inspireFly-VT/Pocketqube-parent-antennaBoard/doc/chapters/Acknowledgments.tex

%
% Acknowledgments.tex
%
% Copyright (C) 2025 by Inspirefly.
%
% 2.305 GHz Patch Antenna Documentation
%

\chapter*{Acknowledgments}
\addcontentsline{toc}{chapter}{Acknowledgments}

Thanks to \textbf{Alek Salvetti} for the MATLAB used throughout this work, including the template antenna \path{matlab/Antenna_minimalistic.mat}, the particle-swarm optimizer \path{matlab/MPA_opt_swrm.m}, and the \path{matlab/best.txt} baseline, as well as guidance on circular-polarization and feed strategies. Also thanks to \textbf{Shane Wyman} for being the Avionics team lead and for his design feedback as a whole.

\vspace{1em}

\bibliography{references/antenna,references/site,references/msp430f6659,references/rf4463f30,references/si4463,references/github}

\addcontentsline{toc}{chapter}{References}
