inspireFly-VT/Pocketqube-parent-antennaBoard/doc/header/authorpage.tex

%
% authorpage.tex
%
% Copyright (C) 2025 by Inspirefly.
%
% 2.305 GHz Circular Patch Antenna Documentation
%
% This work is licensed under the Creative Commons Attribution-ShareAlike 4.0
% International License. To view a copy of this license,
% visit http://creativecommons.org/licenses/by-sa/4.0/.
%

%
% \brief Author page.
%
% \author Inspirefly Antenna Team
%
% \institution Inspirefly / SpaceLab heritage
%
% \version 1.0
%

\thispagestyle{empty}

\begin{center}

\textbf{\thetitle}

\textit{\today}

\vspace{1cm}

\textbf{Project:}

PocketQube Parent Antenna Board -- Inspirefly

\vspace{1cm}

\textbf{Authors:}

Christian G. \\
Inspirefly Antenna Team \\

\vspace{1cm}

\textbf{Contributing History:}

SpaceLab TTC documentation template by Gabriel Mariano Marcelino \\

\vspace{1cm}

\textbf{Revision Control:}

\end{center}

\begin{table}[!ht]
    \begin{center}
        \begin{tabular}{c l p{5cm} c}
            \toprule[1.5pt]
            \textbf{Version} & \textbf{Author}  & \textbf{Changes}    & \textbf{Date} \\
            \midrule
            1.0     & C. G.                     & Circular patch V3, dual coax, FR-408HR stack & 2026/04/28 \\
            0.9     & C. G.                     & Import patch to KiCAD, DXF flow & 2026/03/01 \\
            0.5     & C. G.                     & CircularPatch / HexagonalPatch HFSS & 2025/12/04 \\
            0.2     & C. G.                     & Square aperture calculations & 2025/11/20 \\
            \bottomrule[1.5pt]
        \end{tabular}
    \end{center}
\end{table}

\vfill

\begin{figure}[!h]
	\begin{center}
		
	\end{center}
\end{figure}

\textcopyright\  2025--2026 by Inspirefly. \thetitle. This work is licensed under the Creative Commons Attribution-ShareAlike 4.0 International License. To view a copy of this license, visit \href{http://creativecommons.org/licenses/by-sa/4.0/}{http://creativecommons.org/licenses/by-sa/4.0/}. Template adapted from SpaceLab (UFSC).
