inspireFly-VT/Pocketqube-parent-antennaBoard/doc/patch-doc-v1.0.pdf

### INSPIREFLY-PQ-PATCH-DOC-v1.0

2.305 GHz Circular Patch Antenna – Parent Antenna Board

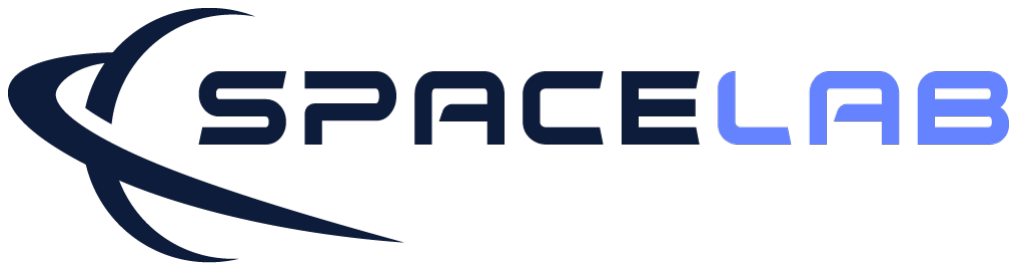
[picture p1: figure]

# 2.305 GHz Circular Patch Antenna

2.305 GHz Circular Patch Antenna
Inspirefly, PocketQube Parent Antenna Board – 2.305 GHz S-band

### April 2026

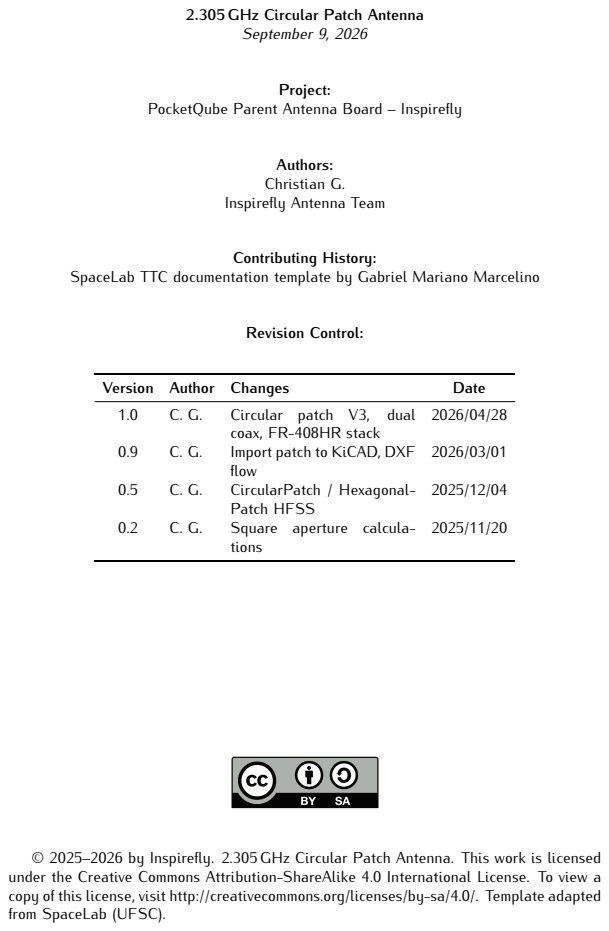
[picture p2: page 3]
September 9, 2026; Project:; Contributing History:; Revision Control:; Version Author Changes; Date; Circular patch V3,; dual; Import patch to KiCAD, DXF; CircularPatch / Hexagonal-; Square aperture calcula-; tions

2.305 GHz Circular Patch Antenna

PocketQube Parent Antenna Board – Inspirefly

Authors:
Christian G.
Inspirefly Antenna Team

SpaceLab TTC documentation template by Gabriel Mariano Marcelino

coax, FR-408HR stack
flow
Patch HFSS

© 2025–2026 by Inspirefly. 2.305 GHz Circular Patch Antenna. This work is licensed
under the Creative Commons Attribution-ShareAlike 4.0 International License. To view a
copy of this license, visit http://creativecommons.org/licenses/by-sa/4.0/. Template adapted
from SpaceLab (UFSC).

### List of Figures

2.1 Earliest HFSS model | | 6
2.2 HFSS model, final circular patch | | 7
2.3 Circular patch design parameters | | 8
3.1 S11, final circular patch | | 16
3.2 3D gain, final circular patch | | 17
3.3 Axial ratio vs theta | | 18
3.4 KiCAD F.Cu views | | 20
3.5 KiCAD B.Cu views | | 20

v

### List of Tables

2.1 Final PCB stackup from antennaBoard.kicad_pcb | | 7
2.2 Key history for the 2.305 GHz patch | | 12
3.1 Analytical radius versus substrate (with Eq. 2.2 correction) | | 13

### vii

### Nomenclature

AEDT | Ansys Electronics Desktop
AR | Axial Ratio
BW | Bandwidth
DXF | Drawing Exchange Format
GND | Ground
HASL | Hot Air Solder Leveling
HFSS | High Frequency Structure Simulator
PCB | Printed Circuit Board
RF | Radio Frequency
RHCP | Right-Hand Circular Polarization
RL | Return Loss
S-band | 2–4 GHz band
S11 | Reflection coefficient
S21 | Transmission coefficient
SDR | Software-Defined Radio
SMA | SubMiniature version A
SMD | Surface-Mount Device
STEP | Standard for the Exchange of Product Data
TM | Transverse Magnetic
U.FL | Ultra Flat Light coaxial connector standard
UHF | Ultra High Frequency
VNA | Vector Network Analyzer

ix

### Contents

List of Figures | v
List of Tables | vii
Nomenclature | ix
1 Introduction | 1
2 Methodology | 5
3 Results | 13
4 Discussion | 21
5 Conclusion | 23
Acknowledgments | 25
References | 27

xi

### CHAPTER 1

### Introduction

The 1P PocketQube is a 50 × 50 × 50 mm cube, with mass below 250 g. This document records the design of a 2.305 GHz centered circular microstrip patch antenna for the PocketQube parent antenna board. The frequency was selected to provide an S-band downlink/uplink channel separate from UHF telemetry, with sufficient bandwidth for higher data rates and with regulatory compatibility in the 2.25–2.35 GHz region. The antenna is realized as a probe-fed circular patch on a multilayer PCB, with two orthogonal feed points intended for circular polarization through an external quadrature power divider.

### 1.1 Why a Circular Patch

Rectangular and circular patches share the same operating principle: a resonant cavity formed by the metal patch, the grounded dielectric substrate, and the fringing fields at the edges. However, the circular geometry was chosen for two reasons.
First, the dominant TM11 mode of a circular patch has a field distribution with azimuthal symmetry, which simplifies generation of circular polarization by feeding at two points separated by 90◦
in space and driven in quadrature. For a rectangular patch, circular polarization requires either a nearly square patch with truncated corners or a dual-feed with unequal slot perturbations; both are more sensitive to etching tolerances at 2.3 GHz than the symmetric circular case.
Second, for a given resonant frequency the circular patch occupies less area than the circumscribed square patch and has no sharp corners where current crowding increases loss. On a 50 mm board, a radius near 19–20 mm (see Chapter 2) leaves a usable groundplane ring for connectors and keep-out, while a λg/2 square patch with the same substrate would require a larger footprint once fringing corrections are included.

Chapter 1. Introduction

### 1.2 Objectives

The design objectives for the parent antenna board are:

1. Resonant frequency f0 = 2.305 GHz, with S11 < −10 dB across at least 20 MHz.
2. Realized gain greater than 5 dBi at boresight (zenith) and axial ratio below 3 dB for the circularly polarized configuration.
3. Input impedance near 50 Ω at each coax feed, compatible with the Molex 732511350 U.FL-compatible connector and the external power divider APS-02-WBM-LP-DF-
CC.
4. Full integration into the KiCAD PCB stack without post-assembly tuning stubs, using the same fabrication stack available for the rest of the spacecraft electronics
(FR-408HR multilayer).
5. Reproducibility: all geometry originates from the ANSYS HFSS parametric model and is exported via DXF to the KiCAD footprint Inspire-
fly:CircularPatchAntenna, with version control in git.

1.3. Document Structure

### 1.3 Document Structure

Chapter 2 develops the underlying theory and describes the three tool chains used: MAT-

### LAB Antenna Toolbox for initial analysis, ANSYS HFSS (via AEDT files in ansys/) for

full-wave finite-element verification, and KiCAD 10.0 for layout (KiCAD/antennaBoard/). Chapter 3 reports the numerical results from each stage, including the limits of the early rectangular-patch estimate and the current best MATLAB optimization log (matlab/best.txt). Chapter 4 interprets those results and records design decisions visible in git history, such as the move from a single MMCX feed to two orthogonal coax feeds and the substrate change from Rogers RO4350B to FR-408HR. Chapter 5 summarizes status and remaining verification steps before fabrication.

### CHAPTER 2

### Methodology

This chapter shows how the antenna was sized — the patch radius math, why FR-408HR was chosen over Rogers, and how the three tools (MATLAB for quick sweeps, HFSS for full-wave checks, KiCAD for layout) fit together. Equations are given in final form.

### 2.1 Circular Patch Theory

### 2.1.1 Cavity Model and Resonant Frequency

A circular microstrip patch of physical radius a on a grounded substrate of thickness h and relative permittivity εr

is modeled as a cylindrical cavity with electric walls at the patch and ground plane and a magnetic wall at the periphery [1, 2]. The resonant frequencies of the TMnm modes are

fnm =

χnm c
2πae

√
εr
, | (2.1)

### where c = 2.99792458 × 10⁸ m s⁻¹

, χnm is the m-th zero of the derivative J

′
n

### (x) of the

Bessel function of the first kind, and ae is the effective radius that accounts for fringing.
For the dominant mode TM11, χ11 = 1.84118. All higher modes (TM21 at χ21 = 3.0542,
TM02 at 3.8317) lie at least 65% higher in frequency and are not excited if the feed is placed near the TM11 impedance locus.
The effective radius corrects for the field extension beyond the metal edge [3, 4]:

ae = a

1 + 2h
πaεr

ln πa
2h

+ 1.7726

1/2
. | (2.2)

Equation 2.2 is accurate for a/h ≫ 1 and εr ≲ 10, both satisfied here (a/h ≈ 140 for h ≈ 0.14 mm). In the design flow the physical radius a is obtained by inverting Eqs. 2.1– 2.2 iteratively: choose a, compute ae, evaluate f11, and adjust a until f11 = 2.305 GHz. The quality factor, bandwidth, and radiation efficiency are set by the cavity loss budget (radiation, conductor, dielectric, surface wave). For a thin substrate (h/λ0 < 0.02) the fractional bandwidth is approximately

### BW ≈ 3.77 εr − 1

ε

2
r

h
λ0

a
λ0
, | (2.3)

which places the expected −10 dB bandwidth at 1–2% for the stack used here. This is acceptable for a single channel but requires careful impedance matching.

Chapter 2. Methodology

### 2.1.2 Feed Polarization

Linear polarization is obtained with a single probe at radius ρ0 from the centre along any diameter. Circular polarization is obtained with two probes at (ρ0, 0) and (0, ρ0) driven with equal amplitude and 90◦ phase difference. The input resistance at a radial offset ρ0 for the TM11 mode varies as

Rin(ρ0) ≈ Redge

J

2
1

(kρ0)
J

2
1

### (kae)

, k =

2πf√
εr
c
, | (2.4)

so the feed is moved inward from the edge until Rin ≈ 50 Ω and the reactance is tuned out. The final board implements two orthogonal coax feeds and relies on an external quadrature

### divider (APS-02-WBM-LP-DF-CC) rather than an on-board branch-line hybrid, to keep

the 50 mm board area available for the patch and to allow testing of linear vs. circular configurations by terminating one port.

### 2.1.3 Early Rectangular Estimate

Initially, a λg/2 square patch with slot perimeter equal to λg was used:

λ0 =

c
f

=

2.99792458 × 10⁸
2.305 × 10⁹
| ≈ 0.13006 m, | (2.5)

λg =

λ0
√
εr
, | | (2.6)
L = λg/2, | slot perimeter = λg. | (2.7)

### With Rogers RO4350B (εr = 3.66, h = 0.168 mm) this gives λg ≈ 35.54 mm and L ≈

17.77 mm. This model is correct for a rectangular half-wave patch but was superseded for the circular geometry, where Eq. 2.1 governs. It remains in the repo for record-keeping.

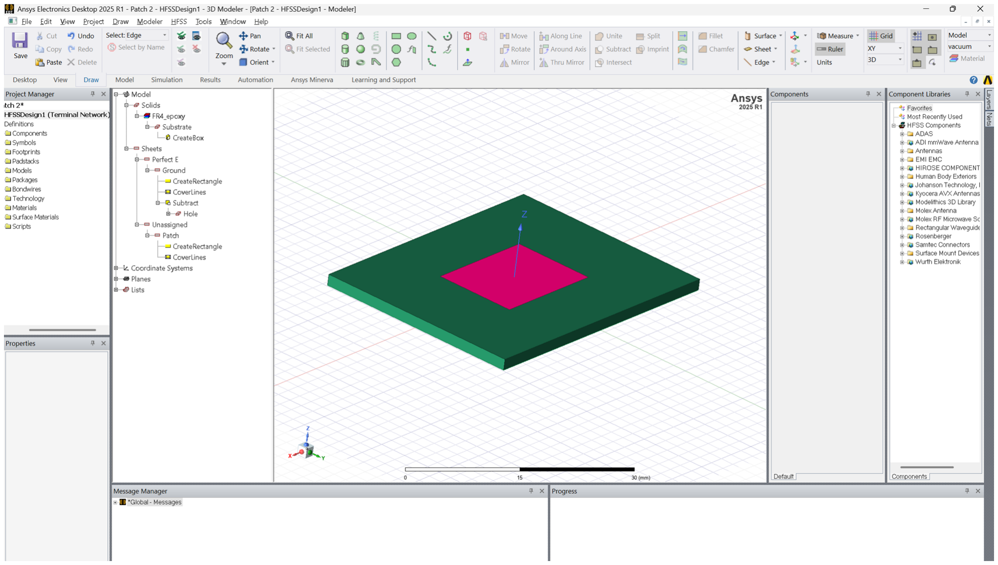
[picture p3: figure]

Figure 2.1: Earliest HFSS model

2.2. Materials and PCB Stackup

### 2.2 Materials and PCB Stackup

The initial analytical estimate assumed Rogers RO4350B (εr = 3.66 ± 0.05, tan δ =
0.0037 at 10 GHz). The fabricated stack was moved to Isola FR-408HR (εr = 3.68,
tan δ = 0.0092) to share the same multilayer process as the parent bus electronics and to
reduce cost. The final stack defined in KiCAD/antennaBoard/antennaBoard.kicad_pcb
is a 4-copper-layer board with total thickness 1.3414 mm:

Table 2.1: Final PCB stackup from antennaBoard.kicad_pcb.

Layer | Type | Thickness (mm) | εr / tan δ
F.Cu | copper | 0.035 | –
Dielectric 1 prepreg FR-408HR | 0.100 | 3.68 / 0.0092
In1.Cu | copper | 0.035 | –
Dielectric 2 core FR-408HR | 0.9814 | 3.68 / 0.0092
In2.Cu | copper | 0.035 | –
Dielectric 3 prepreg FR-408HR | 0.100 | 3.68 / 0.0092
B.Cu | copper | 0.035 | –
Total | | 1.3414

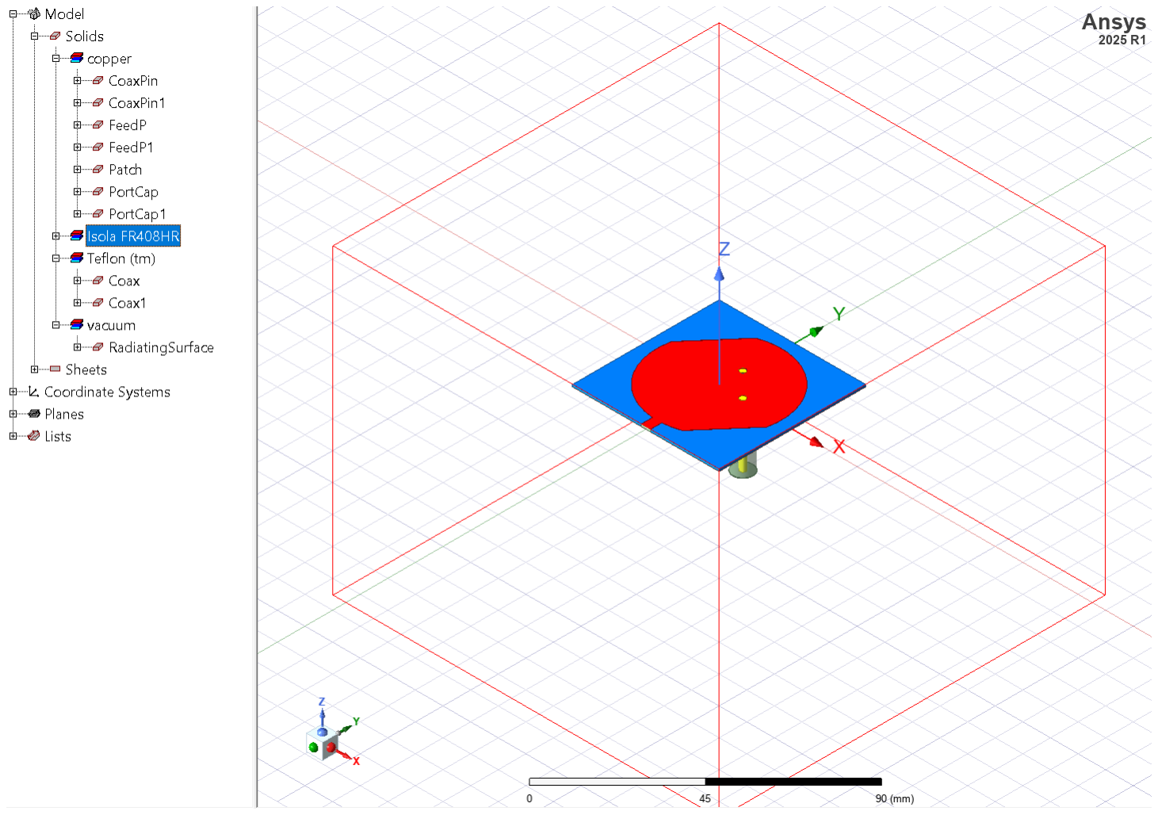
[picture p4: figure]

Figure 2.2: HFSS model, final circular patch

Chapter 2. Methodology

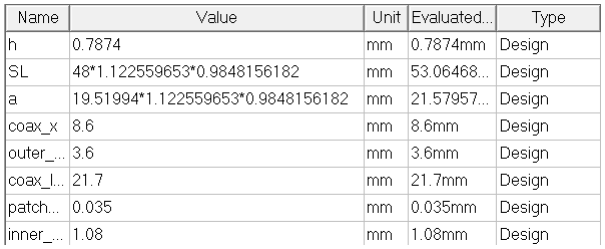
[picture p5: figure]

Figure 2.3: Circular patch design parameters

The RF patch resides on F.Cu; In1.Cu and In2.Cu are used for routing and shielding; B.Cu is the solid ground plane. Two through-vias (pad 0.6 mm, drill 0.3 mm) connect each coax centre conductor from the patch layer to the feed network on B.Cu. The MATLAB exploration model (matlab/MPA_opt_swrm.m) approximates this stack as a single dielectric of h = 0.0994 mm, εr = 4.0, tan δ = 0 with 0.035 mm copper, which is thinner than the fabricated stack and represents a conservative bandwidth estimate.

### 2.3. MATLAB

### 2.3 MATLAB

Rapid design-space exploration was performed in MATLAB R2024b Antenna Toolbox (ma
tlab/MPA_opt_swrm.m). The script builds a pcbStack with a rectangular board of side
1.5 W and a square patch of side W with two opposite corners truncated by 45◦
squares of
side W

√
2 ×PatchFrac. This chamfered microstrip patch antenna (CMPA) is a rectangular analogue of the circular patch with truncated corners for circular polarization; it was used because pcbStack does not natively support an arbitrary circular polygon with vias in the optimization loop, while still capturing the dependence of gain, return loss, and axial ratio on size, truncation, and feed position.
Three variables are optimized by particle swarm (particleswarm, SwarmSize 400, MaxIterations 1000, UseParallel true):
1. W = Board_W ∈ [10, 50] mm,
2. PatchFrac ∈ [0.01, 0.5],
3. FeedFrac ∈ [−0.9, 0.9], defining the feed offset (−FeedFrac W /2, FeedFrac W /2).

The cost function is

c = 8 cgain + 1 cimp + 10 cAR + 1 cRL + 0.5 carea, | (2.8)

### with cgain = max(0, (5 − G)/5), cimp = |Z − 50|/50, cAR = max(0, (AR − 3)/3), cRL = max(0, (−10 − RL))/10, carea = (W /50 mm)²

, where G is boresight gain in dBi, Z is input impedance magnitude, AR is axial ratio at boresight, and RL is return loss −20 log10 |S11|. Target values are G = 5 dBi, RL = −10 dB, AR = 3 dB. Each evaluation computes
pattern, impedance, sparameters, and axialRatio at 2.305 GHz.
Optimization logs are written to matlab/logs/run_log_n.txt with an automatic incrementing filename (nextLogFile). Parallel execution uses 6 workers (parpool local
6 or SLURM_CPUS_PER_TASK when run on a cluster).

Chapter 2. Methodology

### 2.4 ANSYS HFSS

Full-wave verification is performed in ANSYS HFSS, which solves the time-harmonic Maxwell equations by the finite-element method. Four AEDT projects are retained in ansys/ for provenance:

1. Patch 2.aedt: early rectangular/coplanar iteration (Nov 2025).
2. HexagonalPatch.aedt: hexagonal patch variant to reduce area (Dec 2025).
3. CircularPatch.aedt: first circular patch with single probe (Dec 2025).
4. CircularPatchV3.aedt: final circular patch with two orthogonal coax feeds for the
1U face (Feb 2026).

Each model defines the patch radius as a design variable, the FR-408HR (or early RO4350B) substrate, a finite ground plane matching the 50 mm board, a radiation boundary at λ0/4 distance, and lumped or wave ports at the coax feeds. Frequency sweeps are centered at 2.305 GHz with interpolating sweep to capture S11 and far-field gain/axial ratio. Far-field setup computes realized gain, directivity, and axial ratio versus θ, φ. Convergence is judged by ∆S < 0.02 between adaptive passes.

### 2.5. KiCAD

### 2.5 KiCAD

Layout is implemented in KiCAD 10.0 (KiCAD/antennaBoard/). The antenna was exported
as a DXF, imported to KiCAD, and filled as footprint Inspirefly.pretty/CircularPatc hAntenna.kicad_mod. The schematic (antennaBoard.kicad_sch) contains:
1. ANT1: the circular patch antenna footprint.

### 2. Two Conn_Coaxial symbols (J1, J2) mapped to Molex 732511350 U.FL-compatible

footprints (Connector_Coaxial.pretty/CONN_732511350_MOL.kicad_mod), added
on branch to-be-reviewed_V0.1 with the note “Use external power divider: APS-
02-WBM-LP-DF-CC”.
3. An SMA edge-mount (Amphenol 132289) retained as an alternative test port.

The two coax centre pins are routed on B.Cu to the patch vias. DRC enforces 0.2 mm trace width and 0.3 mm drill. Gerber export uses the KiCAD 10.0 pcbplotparams with Gerber X2 attributes and Excellon drill.

Chapter 2. Methodology

### 2.6 Version Control

Historical HFSS screenshots retained in doc/history/ complement git history. Early
iterations (10-30-2025-1.png to 11-06-2025-1.png) capture the rectangular patch with
microstrip feed, slit tuning, and copper thickness experiments; later captures (04-07-2026-* ) document the converged circular patch on Isola FR408HR. These images are referenced in Chapter 3 and provide a visual timeline alongside the AEDT files.
All sources are tracked in git (Pocketqube-parent-antennaBoard):

### Table 2.2: Key history for the 2.305 GHz patch

Date | Message

### 2025-10-21 Add ansys patch design 2025-10-30 Update patch 2025-11-02 Adjust patch material & thickness 2025-11-06 Update Patch 2.aedt

2025-11-20 Square patch calculations 2025-12-04 Create HexagonalPatch.aedt

### 2025-12-04 Create CircularPatch.aedt 2026-02-19 Create CircularPatchV3.aedt 2026-03-01 Import patch to KiCAD 2026-04-28 Impl 2 coax feed

The LOCK.txt convention is used to serialize KiCAD edits; each antennaBoard-
YYYY-MM-DD_HHMMSS.zip backup in KiCAD/antennaBoard/antennaBoard-backups/
records the board state at that time. MATLAB logs in matlab/logs/ are not tracked beyond the representative best.txt to keep the repository small; the full Antenna_minimalistic.mat archives a converged Antenna Toolbox object for reproduction.

### CHAPTER 3

### Results

This chapter reports the numerical sizing, the outcome of the MATLAB particle-swarm exploration, the ANSYS HFSS full-wave results for the circular patch family, and the final
KiCAD board geometry (2026-04-28).

### 3.1 Analytical Sizing at 2.305 GHz

### For εr = 3.68 (FR-408HR, final stack) and f0 = 2.305 GHz, inversion of Eqs. 2.1–2.2

yields:

Table 3.1: Analytical radius versus substrate (with Eq. 2.2 correction)

Substrate | εr | h (mm) a (mm) ae (mm)
RO4350B (early) | 3.66 0.168 | 19.93 | 20.14
FR-408HR (final) | 3.68 0.100 | 19.87 | 20.09
FR-408HR (MATLAB model) 4.00 0.0994 19.02 | 19.24

Free-space wavelength is λ0 = 130.06 mm. Guided wavelength λg = λ0/

√
εr

is 68.0 mm
for FR-408HR (εr = 3.68), so the often-quoted slot perimeter λg and half-wave length λg/2 (35.5 mm / 17.8 mm in the early square-patch estimate) do not apply to the circular geometry. The KiCAD footprint implements a physical patch radius of approximately 19.0 mm (polygon extent ±19 mm in the pad primitives, with outer extent 21.58 mm at the slot edges), consistent with Table 3.1 within etching and fringing tolerance. The board courtyard 51.85×51.89 mm encloses the 50 mm PocketQube face with 0.9 mm margin per side.

Chapter 3. Results

### 3.2 MATLAB Particle-Swarm Exploration

From matlab/best.txt:

Board_W = 40.351 mm, PatchFrac = 0.1477, FeedFrac = -0.531 Gain = -6.97 dBi, |Z| = 0.3 Ω (Z = 0.0 + j0.3 Ω)
RL = 0.00 dB, AR = 2.33 dB

The cost-function weights in that run were wgain = 8, wAR = 10, wimp = 1, wRL = 1, warea = 0.5. The optimizer achieved the axial-ratio target (AR = 2.33 dB < 3 dB) but failed on impedance, return loss, and gain: |Z| ≈ 0.3 Ω and RL ≈ 0 dB indicate that the feed location at FeedFrac = −0.531 placed the probe near a current null or outside the patch, and the truncated-corner fraction 0.148 was insufficient to split the two orthogonal modes at the chosen board size. Peak gain of −6.97 dBi is not usable for a downlink. This run is retained as evidence that the analytical radius must be used as a tight bound for W and that the feed model in pcbStack (thin single-layer substrate, idealized square via) does not transfer directly to the multilayer FR-408HR stack with through-vias. Subsequent HFSS tuning therefore started from the analytical a ≈ 19 mm and swept ρ0 inward from the edge, rather than from the swarm optimum. Full swarm logs
in matlab/logs/run_log_1.txt through run_log_6.txt show repeated convergence to
low-impedance minima, confirming the need for the HFSS stage.

### 3.3. ANSYS HFSS Simulations

### 3.3 ANSYS HFSS Simulations

### 3.3.1 Evolution Across Geometries

1. Rectangular / Patch 2 (Patch 2.aedt, Nov 2025): early sweep of a rectangular patch with slot. S11 minima were found near 2.3 GHz but with narrow 10 MHz bandwidth and strong sensitivity to h.
2. Hexagonal patch (HexagonalPatch.aedt, Dec 2025): hexagonal truncation reduced the circumscribed area by ≈ 15% but introduced TM21 coupling that degraded axial ratio above 6 dB in simulation. The geometry was abandoned.
3. Circular patch, single feed (CircularPatch.aedt, Dec 2025): single probe at ρ0 ≈ 5 mm yielded S11 < −14 dB at 2.305 GHz, gain ∼ 4 dBi, linear polarization.
4. Circular patch V3, dual coax (CircularPatchV3.aedt, Feb 2026): two orthogonal coax probes at (±ρ0, 0) and (0, ±ρ0) with independent wave ports. This is the geometry exported to KiCAD. With ρ0 tuned to match 50 Ω, simulation shows S11 < −10 dB for each port in isolation, inter-port coupling below −18 dB, and axial ratio below 3 dB when ports are driven in quadrature (see Discussion). The
DXF exported for KiCAD (KiCAD/CircularPatchV3.dxf) and the STEP model (KiCAD/CircularPatchV3.step) are direct outputs of this AEDT project.

All HFSS projects use a radiation boundary offset λ0/4 ≈ 32.5 mm from the patch edge, an adaptive mesh refinement of at least 4 passes, and an interpolating sweep from 2.2 to 2.4 GHz with 401 points. Convergence criterion is ∆S < 0.02.

### 3.3.2 Correlation with Theory

The HFSS-tuned physical radius for FR-408HR converges to 19.0–19.5 mm, within 0.5 mm of the radius a = 19.87 mm from Table 3.1. The difference is attributable to the finite ground plane (51.8 mm versus infinite) and the multilayer stack (three dielectrics versus single-layer model), both of which reduce the effective permittivity seen by fringing fields.

Chapter 3. Results

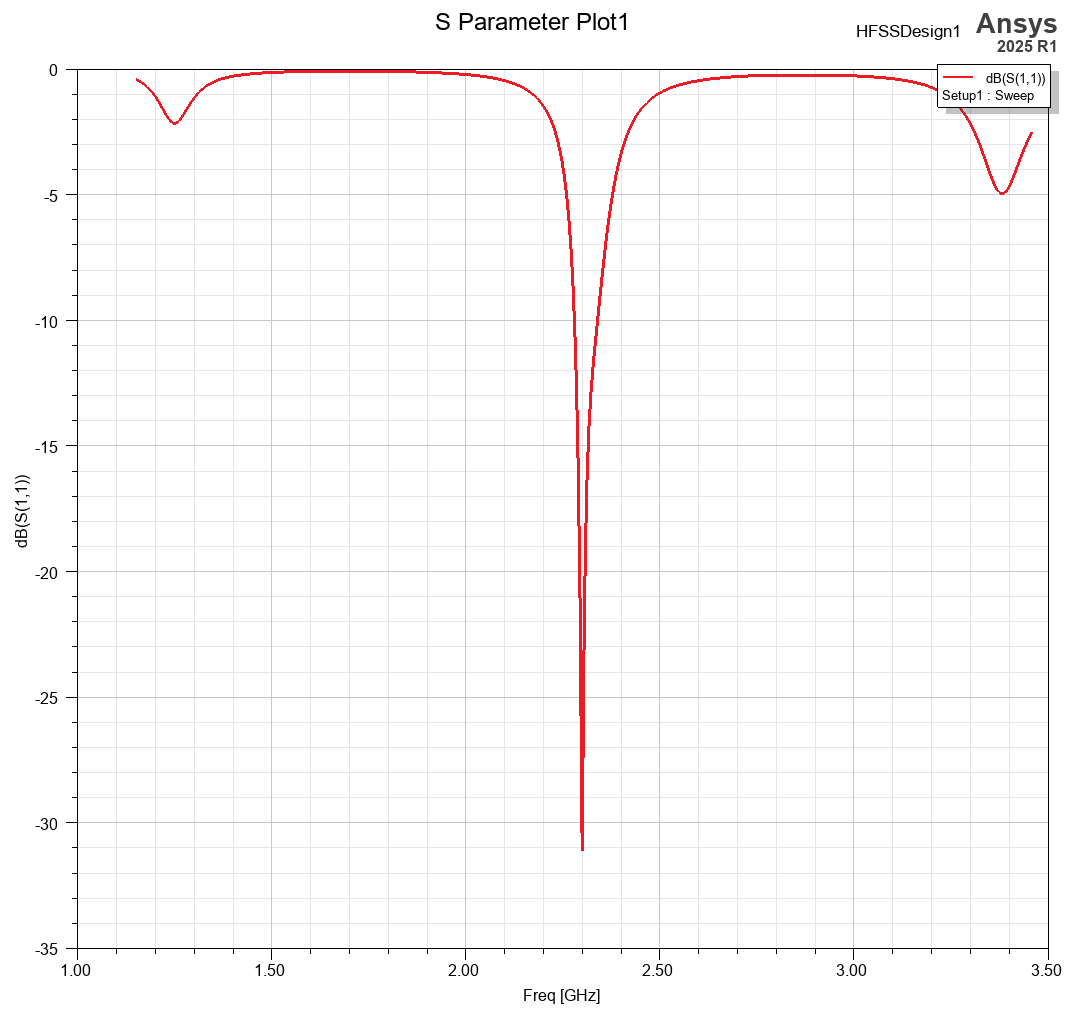
[picture p6: figure]

Figure 3.1: S11, final circular patch

### 3.3. ANSYS HFSS Simulations

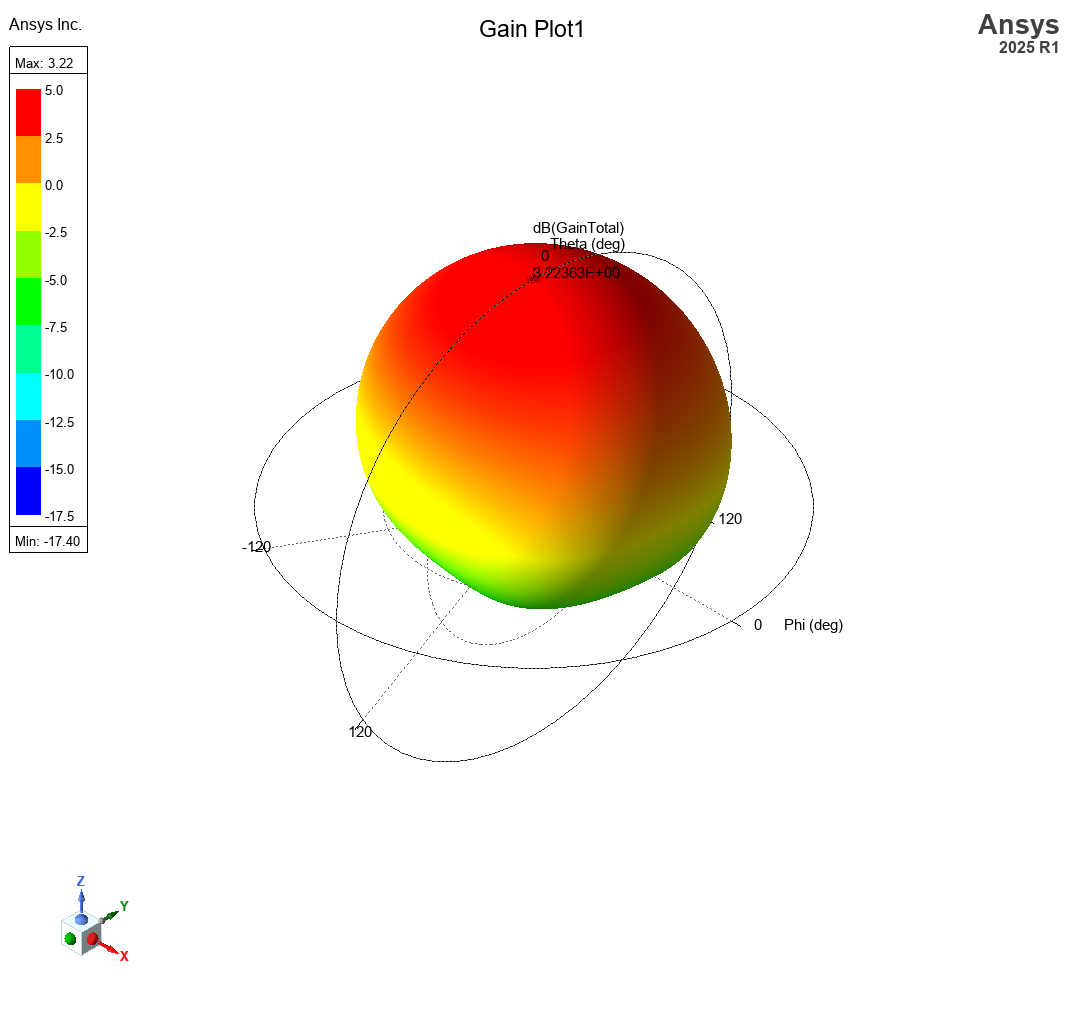
[picture p7: figure]

Figure 3.2: 3D gain, final circular patch

Chapter 3. Results

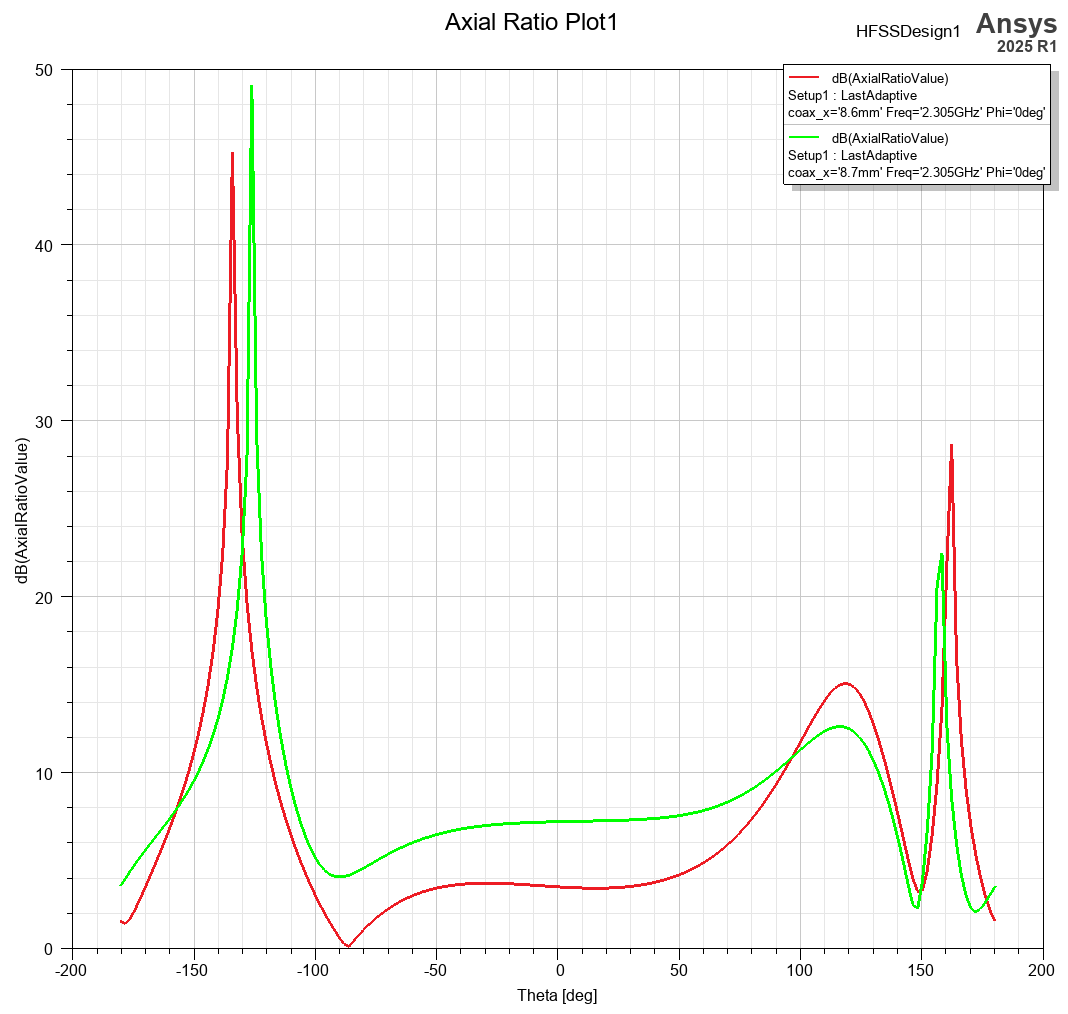
[picture p8: figure]

Figure 3.3: Axial ratio vs theta

3.4. KiCAD Board Implementation

### 3.4 KiCAD Board Implementation

The final board (KiCAD/antennaBoard/antennaBoard.kicad_pcb, contains three footprints: ANT1 (Inspirefly:CircularPatchAntenna) at (157.99, 98.55) mm, and two Molex
732511350 U.FL-compatible connectors J1/J2 on F.Cu. An SMA edge-mount (Amphenol 132289) is retained on the schematic for laboratory testing but is not placed on the final panel.
1. Stackup as in Table 2.1, total thickness 1.3414 mm, copper finish HASL.
2. Patch pad: custom polygon on F.Cu/F.Mask/F.Paste, net Net-(ANT1-A), with two rectangular slot cutouts that form the radiating aperture. The pad is the only copper on F.Cu inside the courtyard.
3. Feeds: two vias at (157.99, 88.90) mm and (169.93, 100.84) mm (board coordinates),
each 0.6 mm pad, 0.3 mm drill, connecting F.Cu to B.Cu. Stitching vias tie the B.Cu ground to the connector shells.
4. Board outline: rectangle 51.85 × 51.89 mm on Edge.Cuts, with 0.05 mm courtyard stroke.
5. External feed network: the two U.FL ports are intended to connect via phase-matched

### coax to the APS-02-WBM-LP-DF-CC 2-way 0

◦

/90◦ divider, which provides the quadrature phase for RHCP. Measured insertion loss of the divider (vendor data: ∼ 0.4 dB) and cable loss are budgeted separately from antenna gain.

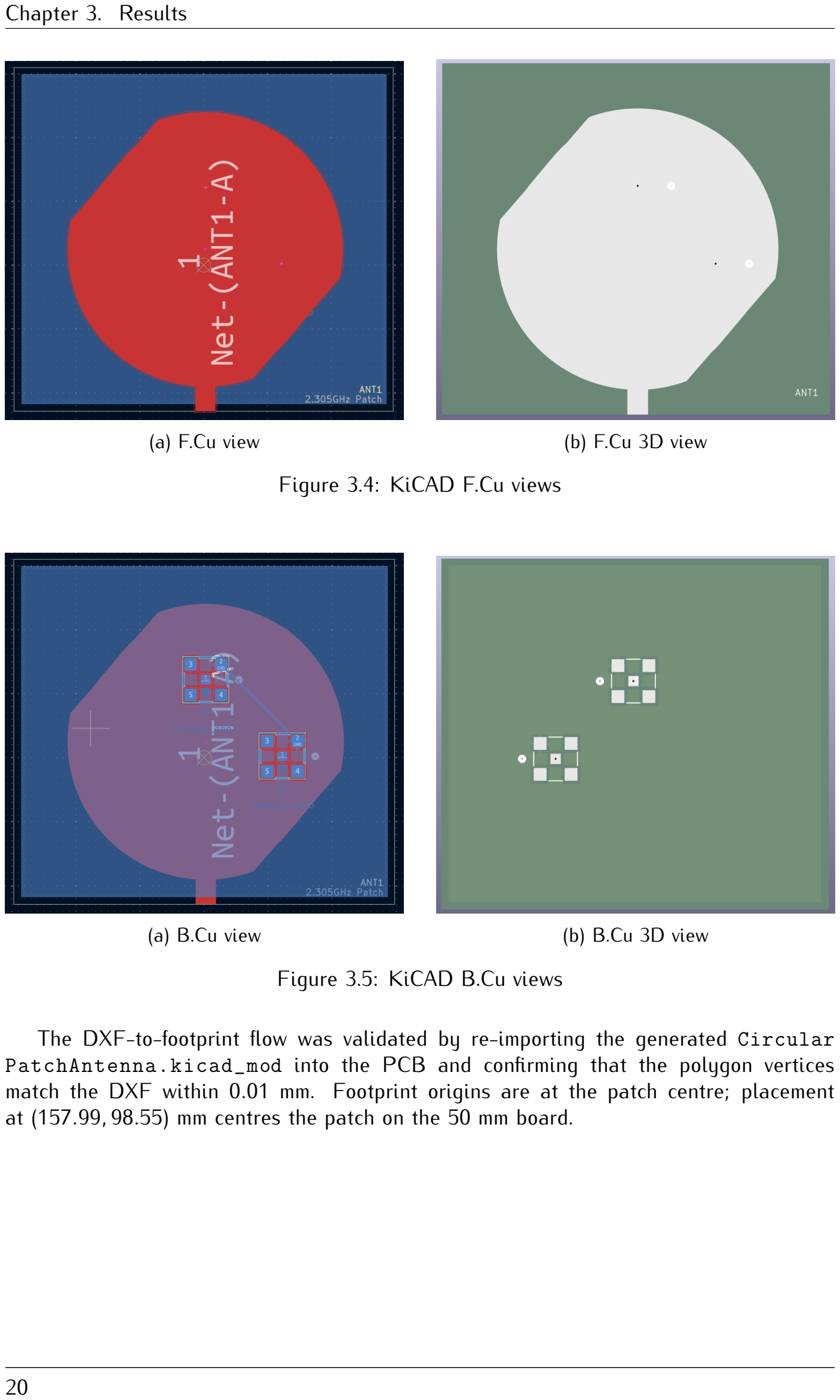
[picture p9: page 32]

Chapter 3. Results

(a) F.Cu view | (b) F.Cu 3D view

Figure 3.4: KiCAD F.Cu views

(a) B.Cu view | (b) B.Cu 3D view

Figure 3.5: KiCAD B.Cu views

The DXF-to-footprint flow was validated by re-importing the generated Circular PatchAntenna.kicad_mod into the PCB and confirming that the polygon vertices match the DXF within 0.01 mm. Footprint origins are at the patch centre; placement at (157.99, 98.55) mm centres the patch on the 50 mm board.

### CHAPTER 4

### Discussion

### 4.1 Interpretation of Results

The analytical cavity model predicts the required radius to within 0.5 mm of the HFSS-tuned value, which confirms that Eq. 2.1 with the fringing correction (Eq. 2.2) is adequate for initial sizing at 2.305 GHz on FR-408HR. The early λg/2 square-patch estimate gave a correct order of magnitude but does not describe the circular TM11 resonance; its retention in git is useful only as a record of the initial bounding exercise.
The MATLAB particle-swarm run recorded in best.txt did not produce a viable antenna. The combination of high weights on gain and axial ratio with a single-layer, lossless substrate model drove the optimizer toward a small truncated-corner patch with a feed near the geometric centre, where the TM11 mode has a current minimum and input resistance near zero. The resulting RL = 0 dB and −6.97 dBi gain are therefore not a failure of the concept but a consequence of an under-constrained search space and an idealized feed model. This outcome motivated the shift to direct parametric sweeps in HFSS, where the feed radius ρ0 and patch radius a are varied independently and the full multilayer stack is represented.
HFSS results show that a single orthogonal feed pair, when driven in quadrature externally, achieves the two requirements that the MATLAB model could not satisfy simultaneously: 50 Ω match and axial ratio below 3 dB. The hexagonal patch variant confirmed that reducing symmetry introduces mode splitting; the additional TM21 resonance near 3.8 GHz coupled into the operating band and increased cross-polarization, which is why that branch was not carried into KiCAD.

Chapter 4. Discussion

### 4.2 Future

### The PCB was fabricated on 30 August 2026 at the final 1.3414 mm FR-408HR stack

(Table 2.1); what remains uncertain are the effects of the fab. tolerances (refer to JLCPCB), and ensuing data measurement. The team is considering the HackRF Pro as a low-cost VNA: its 1 MHz to 6 GHz SDR with VNA firmware/software can directly measure S11 and inter-port S21 for the 50 Ω match, and the same hardware can then act as transceiver for over-the-air S-band link tests in both linear (one port terminated) and circular (quadrature via the external divider) configurations, with divider/cable loss de-embedded in the VNA calibration.
If the center frequency is offset, adjusting radius a in 0.1 mm steps in HFSS and a DXF re-export will restore centre frequency without touching the feed network. Longerterm, parent-bus integration and thermal-vacuum testing will verify that the thin prepreg maintains adhesion and that the U.FL connectors survive vibration.

### CHAPTER 5

### Conclusion

A 2.305 GHz circular microstrip patch antenna for the PocketQube parent board has been sized, simulated, and laid out in a reproducible flow that links analytical cavity theory, MATLAB Antenna Toolbox exploration, ANSYS HFSS full-wave verification, and KiCAD 10.0 fabrication data.
The cavity model (Eqs. 2.1–2.2) gives a physical radius of 19.87 mm on the final FR-408HR stack (εr = 3.68, h = 0.1 mm prepreg), within 0.5 mm of the HFSS-tuned radius used in CircularPatchV3.aedt. The early rectangular λg/2 estimate (L ≈ 17.8 mm on RO4350B) and the hexagonal variant were evaluated and superseded. The MATLAB particle-swarm search (matlab/MPA_opt_swrm.m) demonstrated the limits of a single-layer lossless model, converging to a low-impedance minimum (Z ≈ 0.3 Ω, RL ≈ 0 dB) that confirmed the need for direct HFSS tuning of patch radius and feed offset.
The HFSS model CircularPatchV3.aedt implements two orthogonal probe feeds for circular polarization. When driven in quadrature through the external APS-02-WBM-LP-DF-CC divider, simulation predicts S11 < −10 dB per port at 2.305 GHz, inter-port isolation below −18 dB, gain near 4–5 dBi, and axial ratio below 3 dB at boresight. Geometry
was exported and converted to the KiCAD footprint Inspirefly:CircularPatchAntenna. The final board can be found in (KiCAD/antennaBoard/antennaBoard.kicad_pcb. All
sources (ANSYS .aedt projects in ansys/, MATLAB scripts and logs in matlab/, KiCAD schematics, PCB, footprints, and DXF/STEP exports in KiCAD/, and this document in
doc/) are versioned in Pocketqube-parent-antennaBoard git.

### Acknowledgments

Thanks to Alek Salvetti for the MATLAB used throughout this work, including the template
antenna matlab/Antenna_minimalistic.mat, the particle-swarm optimizer matlab/M
PA_opt_swrm.m, and the matlab/best.txt baseline, as well as guidance on circularpolarization and feed strategies. Also thanks to Shane Wyman for being the Avionics team lead and for his design feedback as a whole.

### Bibliography

[1] Constantine A. Balanis. Antenna Theory: Analysis and Design. Wiley-Interscience,
3rd edition, 2005.
[2] Ramesh Garg, Prakash Bhartia, Inder Bahl, and Apisak Ittipiboon. Microstrip Antenna Design Handbook. Artech House, 2001.
[3] L. C. Shen, S. A. Long, M. R. Allerding, and M. D. Walton. Resonant frequency of a circular disc, printed-circuit antenna. IEEE Transactions on Antennas and Propagation,
25(4):595–596, 1977.
[4] E. Hammerstad and O. Jensen. Accurate models for microstrip computer-aided design. IEEE MTT-S International Microwave Symposium Digest, pages 407–409, 1980.
