inspireFly-VT/Pocketqube-parent-antennaBoard/KiCAD/antennaBoard/antennaBoard.kicad_pcb

## KiCad design KiCAD/antennaBoard/antennaBoard.kicad_pcb (2026-09-09)

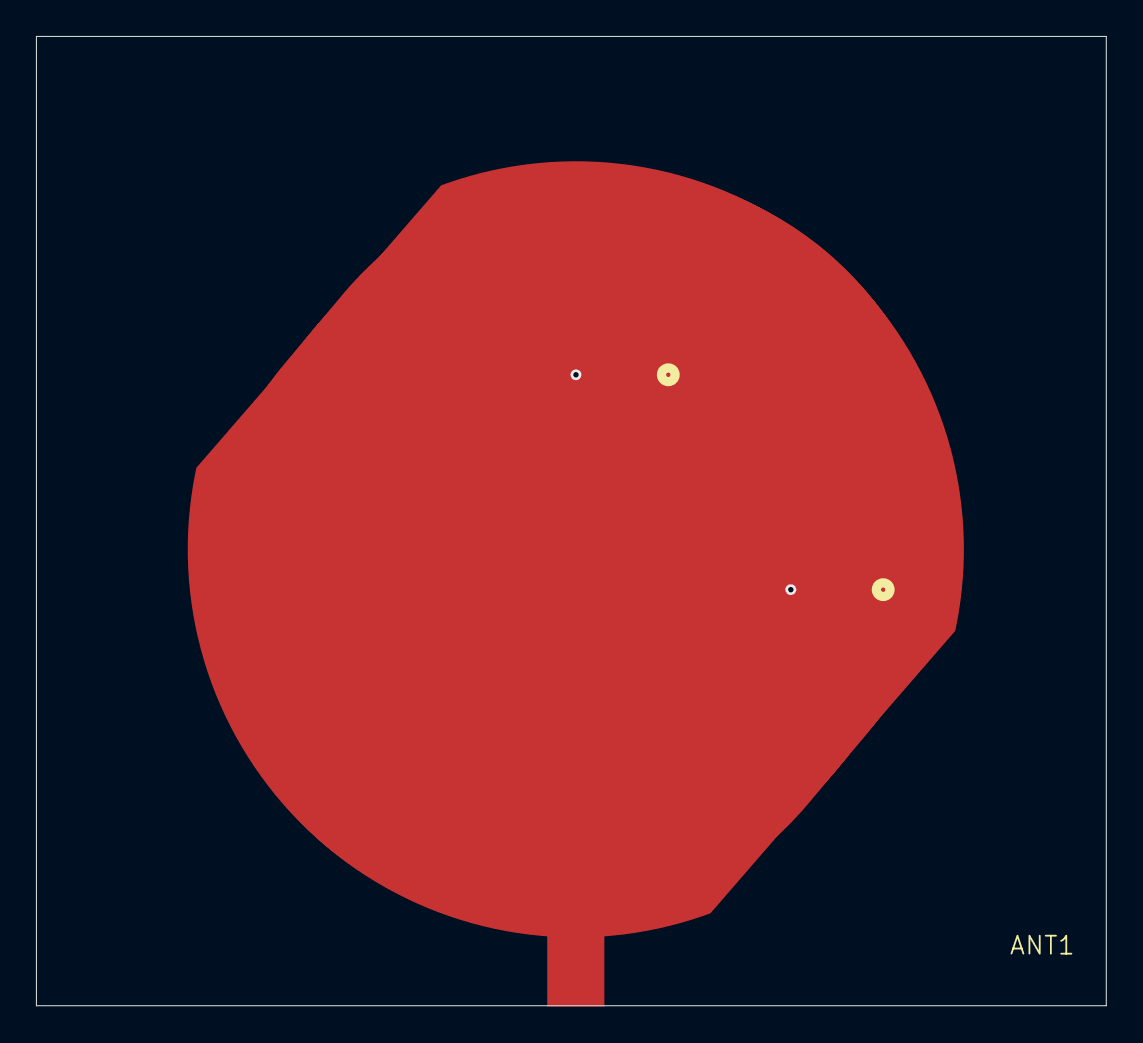
[picture p14: board antennaBoard.kicad_pcb from above]

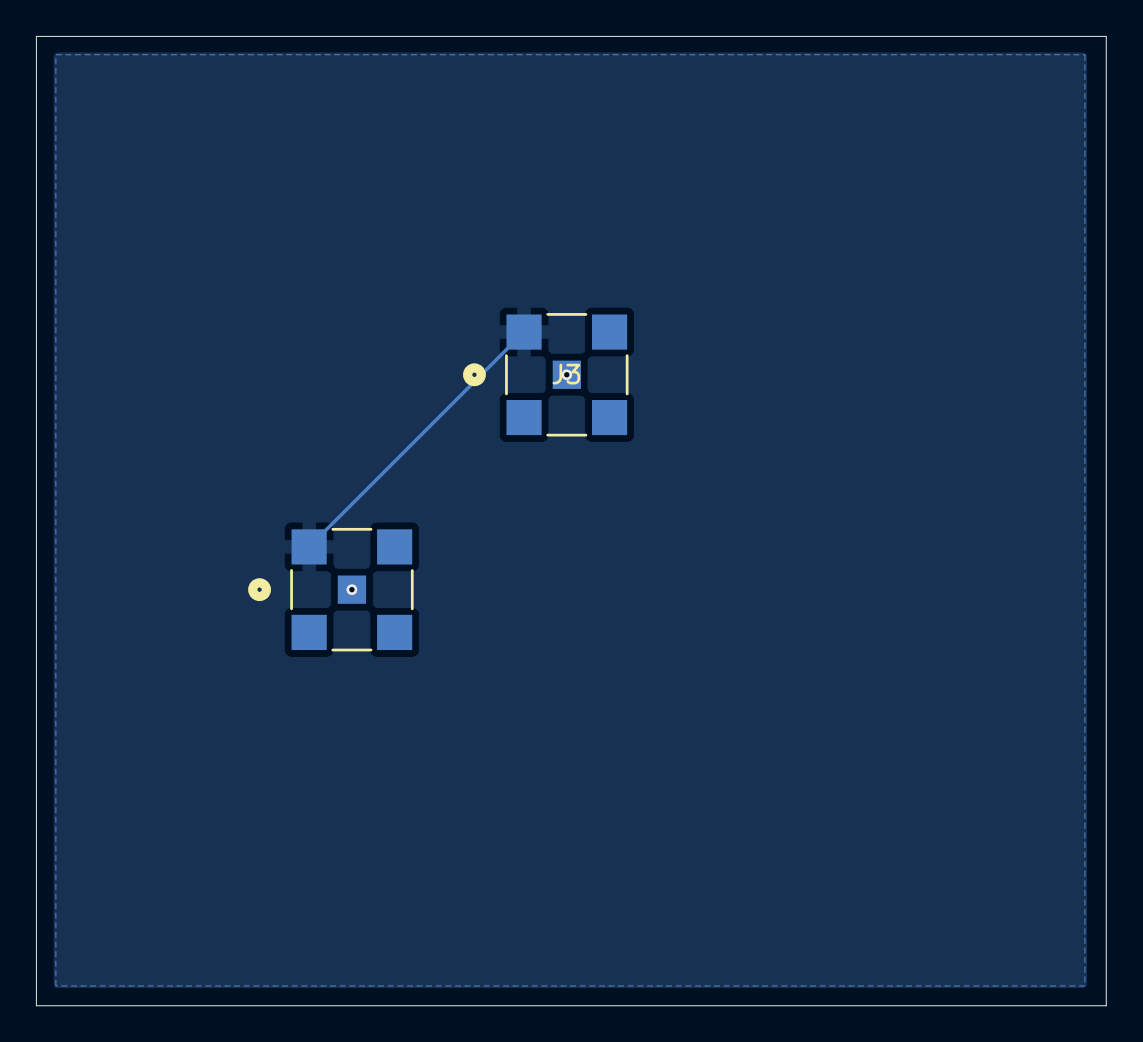
[picture p15: board antennaBoard.kicad_pcb from below]

Board: 4 copper layers, 59.4 x 53.8 mm, 3 parts (2 on the bottom side), 2 nets.

Parts:
ANT1: 2.305GHz Patch; CircularPatchAntenna
J1, J3: Conn_Coaxial; CONN_732511350_MOL

Connections:
GND: J1.2 (Ext), J3.2 (Ext)
unnamed: ANT1.1 (A_1), J1.1 (In), J3.1 (In)
